soso1999/GA-Headset-USB-Adapter/LICENSES/README.md

# Lizenzzuordnung

Copyright © 2026 Josef Jankarashvili.

Für die verschiedenen Bestandteile dieses Projekts gelten folgende Lizenzen:

- `cad/**`, `v2/cad/**`, `hardware/**`, `v2/hardware/**` sowie die elektrische Schaltungs-, Verdrahtungs- und Aufbaudokumentation einschließlich `v2/docs/wiring.md` und `v2/docs/build.md`:
  **CERN Open Hardware Licence Version 2 – Permissive (`CERN-OHL-P-2.0`)**.  
  Der vollständige Lizenztext befindet sich unter `LICENSES/CERN-OHL-P-2.0.txt`.

- Allgemeine Dokumentation, `README.md`, Release Notes, Troubleshooting-Texte, Fotos und sonstige nicht zur Hardwarekonstruktion gehörende Inhalte:
  **Creative Commons Attribution 4.0 International (`CC-BY-4.0`)**.  
  Der vollständige Lizenztext befindet sich unter `LICENSES/CC-BY-4.0.txt`.

Die Lizenztexte selbst bleiben unverändert und werden unter den Bedingungen ihrer jeweiligen Urheber bereitgestellt.

Bei Weitergabe oder Bearbeitung müssen die jeweils geltenden Lizenz- und Attributionshinweise erhalten bleiben.

Hersteller- und Produktnamen sowie Marken werden ausschließlich zur Beschreibung kompatibler oder verwendeter Produkte genannt. Ihre Verwendung bedeutet weder eine Zugehörigkeit zu noch eine Unterstützung oder Zertifizierung durch die jeweiligen Rechteinhaber.
