soso1999/GA-Headset-USB-Adapter/releases/v2.0.0.md

# v2.0.0 — GA Headset USB Adapter with Analog Sidetone

V2 erweitert den funktionierenden Dual-GA-auf-USB-Adapter um einen regelbaren analogen Sidetone.

## Neu in V2

- Analoger Sidetone mit praktisch keiner wahrnehmbaren Software-Latenz
- OPA2134PA-basierter Mikrofon-Vorverstärker
- 10-kΩ-Log-Poti zur Sidetone-Lautstärkeregelung
- separate Sidetone-Zusatzplatine
- überarbeitete passive Kopfhörer-Mischung
- Stereo-PC-Audio bleibt erhalten
- neues Gehäuse mit außen zugänglichem Sidetone-Regler
- druckfertige STL-Dateien für Unterteil, Deckel und isolierende Zwischenablage
- parametrische OpenSCAD-Quelldateien für Gehäuse und Sidetone-Knauf
- druckbarer Sidetone-Drehknopf für den verwendeten Poti-Schaft

## Finale getestete Kopfhörer-Mischung

```text
USB LEFT  -> 100 Ω -> J2 Tip
USB RIGHT -> 100 Ω -> J2 Ring

SIDETONE OUT -> 220 Ω -> J2 Tip
SIDETONE OUT -> 220 Ω -> J2 Ring
```

Die beiden Sidetone-Widerstände sind getrennt; Tip und Ring werden nicht direkt miteinander verbunden.

## Teststand

Der V2-Prototyp wurde im PC-/Simulatorbetrieb mit einem Lightspeed Zulu 4 Dual-GA getestet.

Im fertigen Aufbau:

- klare Sprachwiedergabe
- sauberes PC-Audio
- funktionierende Stereo-Kanäle
- regelbarer Sidetone auf beiden Ohren
- praktisch keine wahrnehmbare Sidetone-Latenz
- kein störendes Hintergrundgeräusch beim Zulu 4

Der 100-kΩ-Gain-Trimmer war beim getesteten Prototyp auf ungefähr 14,3 kΩ effektiven Widerstand eingestellt.

## Dokumentation

V2-Dokumentation befindet sich unter `v2/`.

## Sicherheit

Nur für PC-/Simulatorbetrieb. Keine zertifizierte Luftfahrtausrüstung. Nicht im Flugzeug verwenden und nicht an Flugzeug-Audio-, Funk-, Intercom- oder Bordstromsysteme anschließen.
