soso1999/GA-Headset-USB-Adapter/docs/images/V1 finished-device.jpg

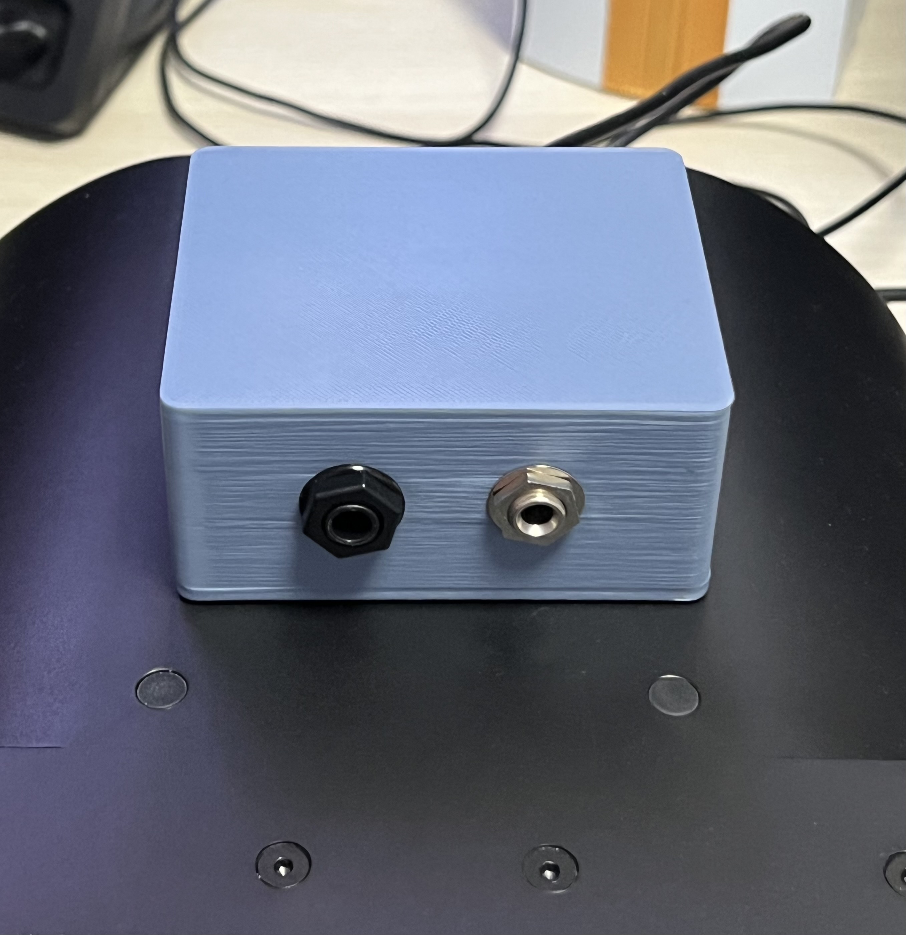
docs/images/V1 finished-device.jpg
