soso1999/GA-Headset-USB-Adapter/v2/cad/previews/GA_Headset_V2_Gehaeuse_Vorschau.png

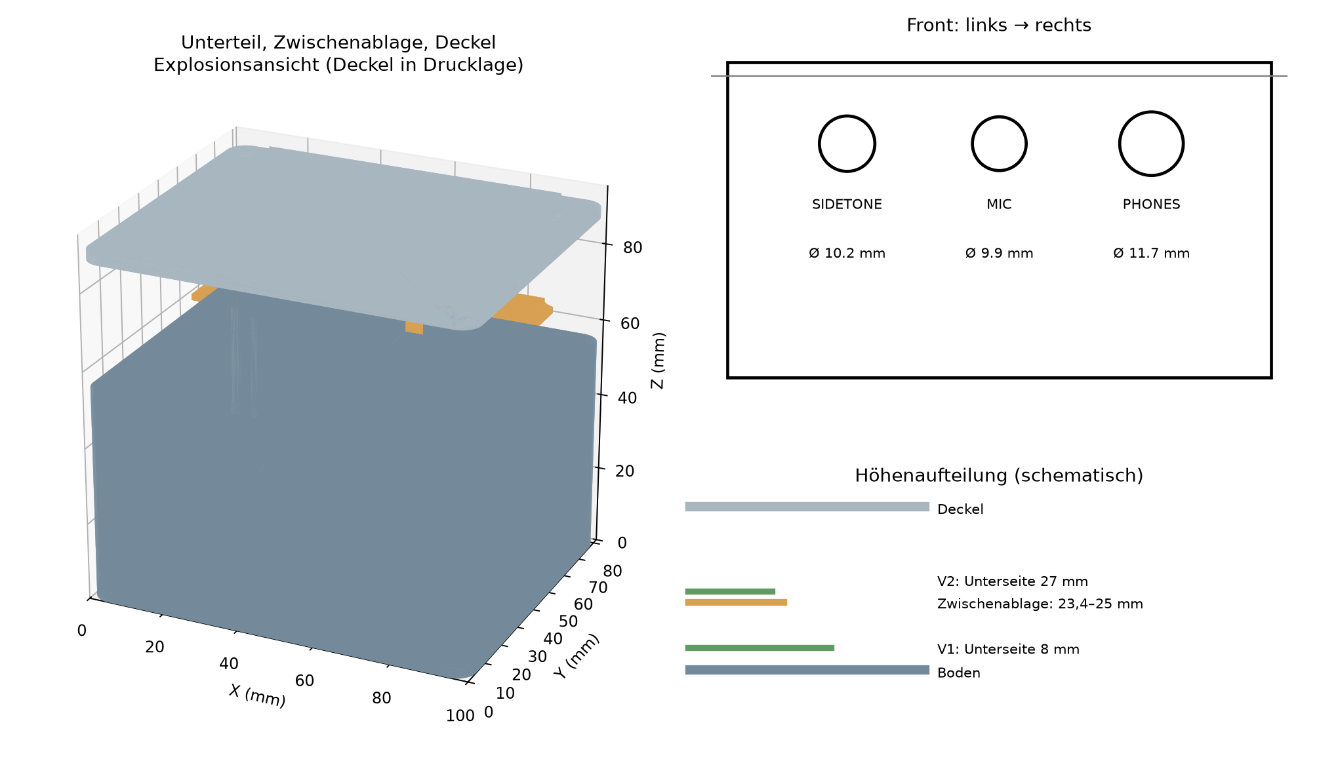
v2/cad/previews/GA_Headset_V2_Gehaeuse_Vorschau.png
