soso1999/GA-Headset-USB-Adapter/v2/cad/previews/GA_Headset_V2_Knauf_Vorschau.png

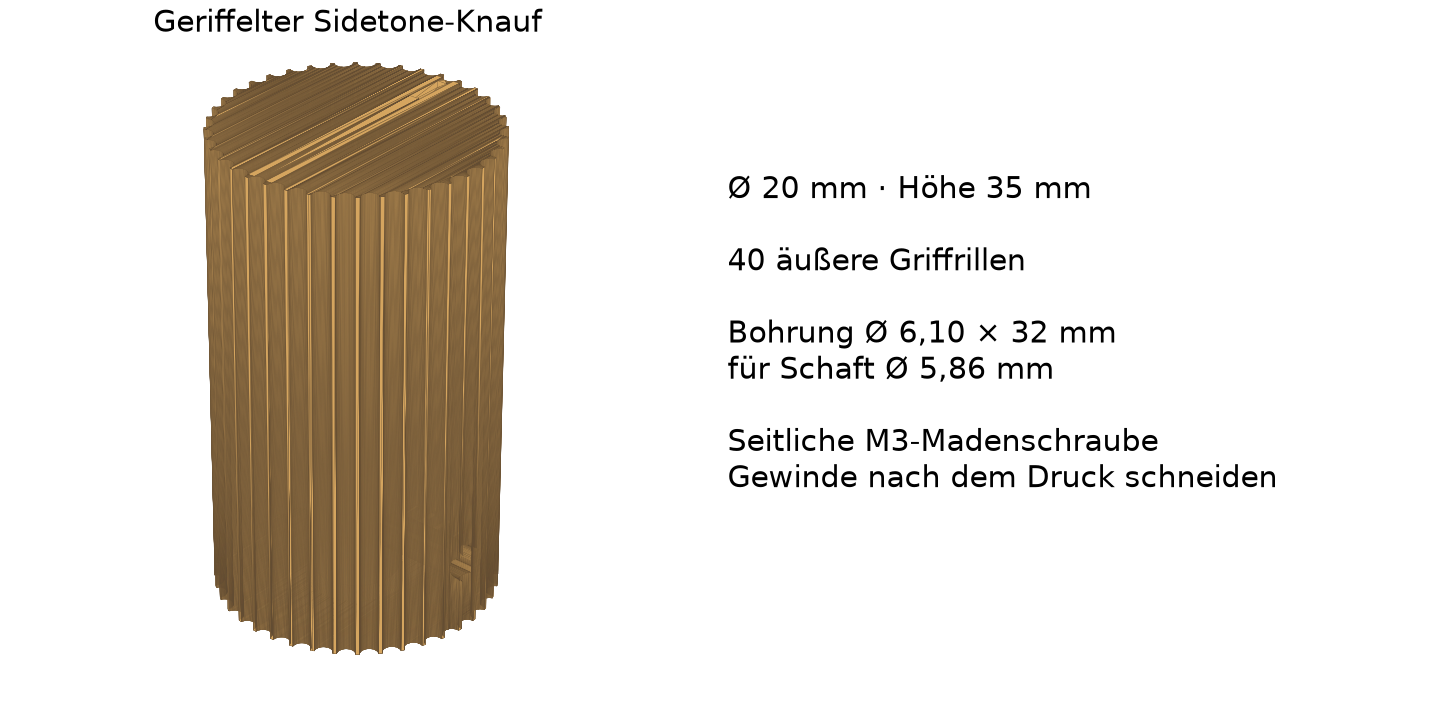
v2/cad/previews/GA_Headset_V2_Knauf_Vorschau.png
