soso1999/GA-Headset-USB-Adapter/v2/cad/stl/GA_Headset_V2_Knauf.stl

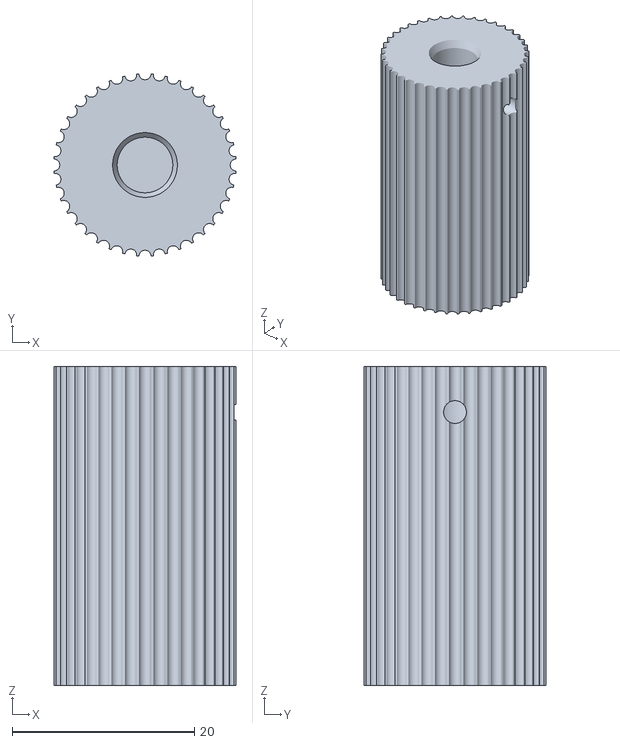
[picture p9: CAD file, 2026-10-13]
v2/cad/stl/GA_Headset_V2_Knauf.stl
20.0 x 20.0 x 35.0
