soso1999/GA-Headset-USB-Adapter/v2/cad/stl/GA_Headset_V2_Unterteil.stl

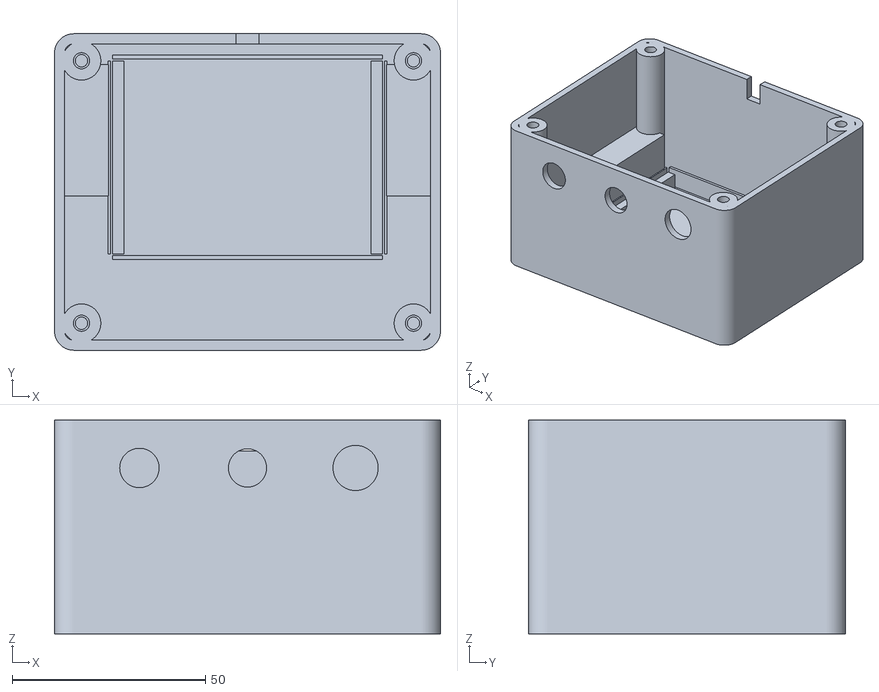
[picture p10: CAD file, 2026-10-13]
v2/cad/stl/GA_Headset_V2_Unterteil.stl
100.0 x 82.0 x 55.4
