soso1999/GA-Headset-USB-Adapter/v2/cad/stl/GA_Headset_V2_Deckel.stl

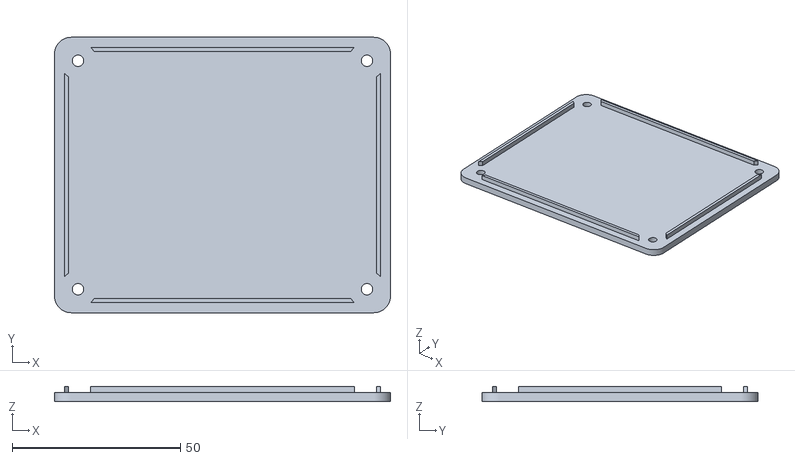
[picture p11: CAD file, 2026-10-13]
v2/cad/stl/GA_Headset_V2_Deckel.stl
100.0 x 82.0 x 4.40
