soso1999/GA-Headset-USB-Adapter/v2/cad/stl/GA_Headset_V2_Zwischenablage.stl

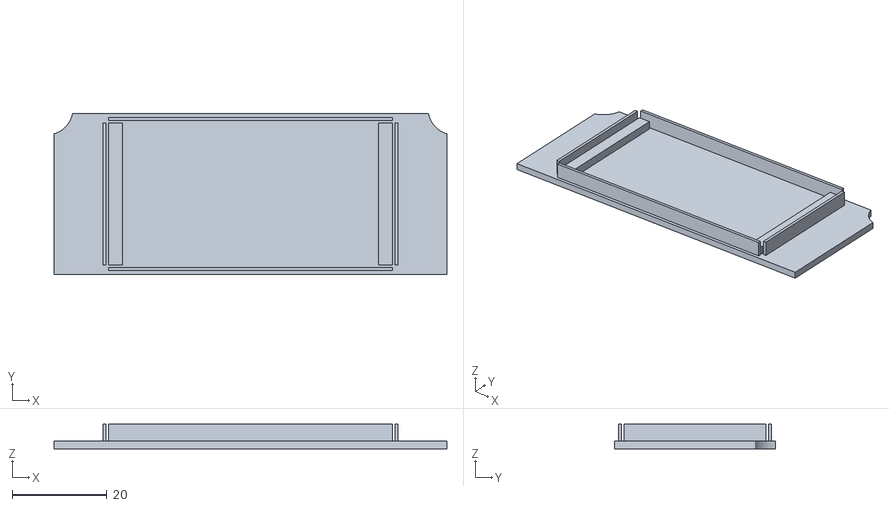
[picture p12: CAD file, 2026-10-13]
v2/cad/stl/GA_Headset_V2_Zwischenablage.stl
83.0 x 34.0 x 5.20
