soso1999/GA-Headset-USB-Adapter/CHANGELOG.md

# Änderungsverlauf

## v2.0.0 — 2026-10-13

Zweite getestete Version des GA Headset USB Adapters.

Neu:

- analoge, regelbare Sidetone-Funktion
- OPA2134PA-basierte V2-Zusatzplatine
- 10-kΩ-Log-Poti für Sidetone-Lautstärke
- passive Stereo-Mischung mit 100-Ω-Serienwiderständen an den USB-Soundkarten-Ausgängen und getrennten 220-Ω-Sidetone-Widerständen
- neues Gehäuse mit Sidetone-Regler an der Front
- V2-CAD-Dateien und druckfertige STLs für Unterteil, Deckel und Zwischenablage
- eigener 3D-gedruckter Sidetone-Knauf
- neue V2-Bilder, BOM, Verdrahtung, Aufbau- und Troubleshooting-Dokumentation

Der getestete V2-Prototyp funktioniert mit dem Lightspeed Zulu 4 Dual-GA sehr gut.

## v1.0.0 — 2026-10-06

Erste veröffentlichte Version des funktionierenden V1-Prototyps.

Enthalten sind die Original-STLs und das Gerätefoto sowie der dokumentierte elektrische Schaltplan, die Stückliste, die Verdrahtung, die Aufbau- und Inbetriebnahmeanleitung, der Disclaimer und die Lizenzzuordnung.

V1 bleibt als ursprünglicher stabiler Projektstand erhalten.
