soso1999/GA-Headset-USB-Adapter/(commit log)

2026-10-13 Remove internal layout image for V2 prototype
    Removed internal layout image from README.
2026-10-13 Rename finished-device.jpg to V1 finished-device.jpg
