soso1999/GA-Headset-USB-Adapter/IMG_3172.jpeg

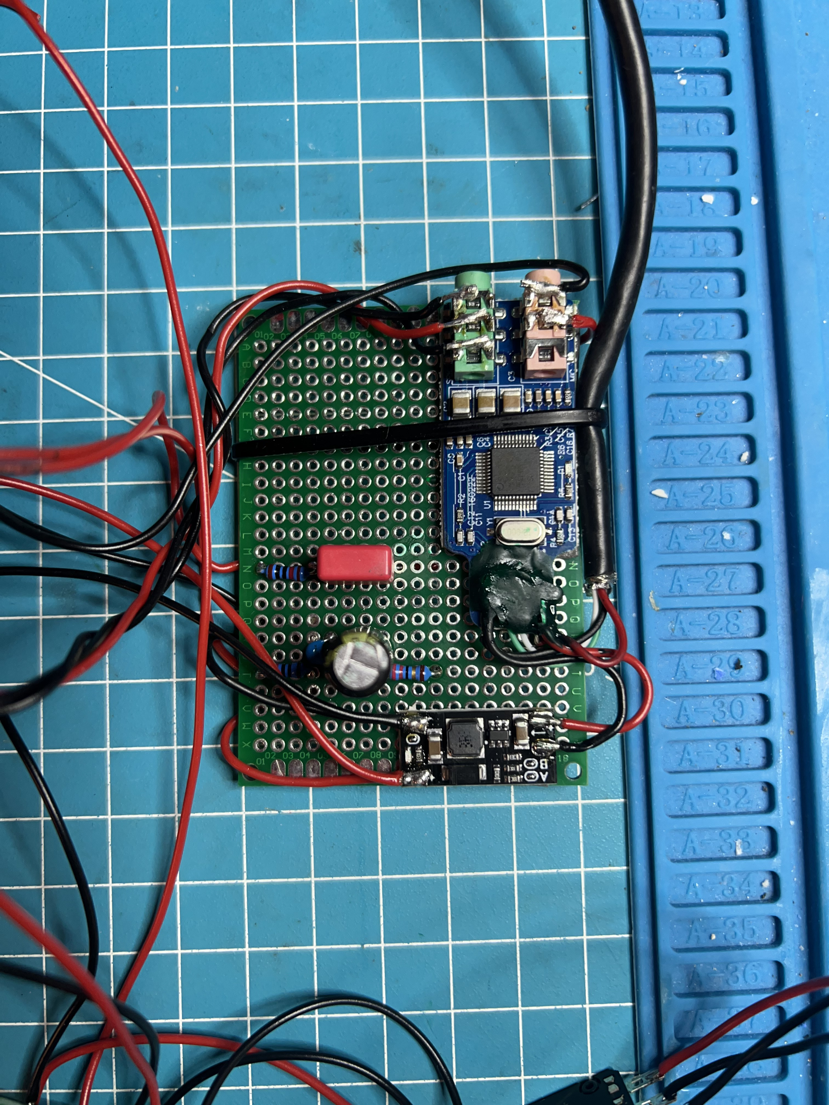
IMG_3172.jpeg
